mrstein/YANHAA/README.md

# YANHAA
YANHAA - You Are Not Heartless After All is an electronical stethoscope based on a MK20DX256 (TEENSY 3.2).
Still Work In Progress, the 3D files are not finished yet.
