mrstein/YANHAA/SW/PARABOLE.SLDPRT

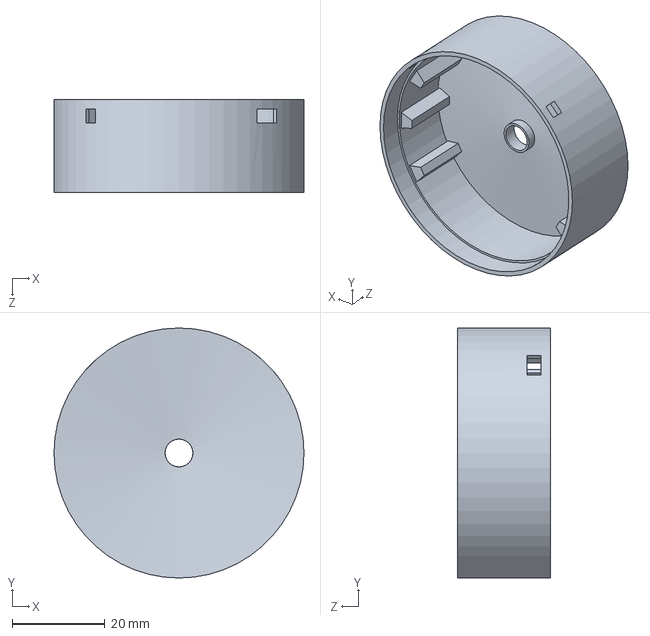
[picture p1: CAD file, 2017-12-03]
SW/PARABOLE.SLDPRT
54.0 x 54.0 x 20.0 mm
