mrstein/YANHAA/SW/Stethoscope v1.0.SLDPRT

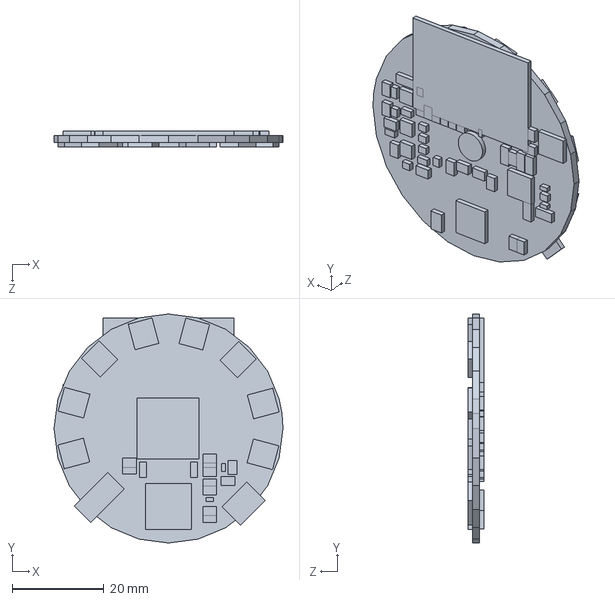
[picture p2: CAD file, 2017-12-03]
SW/Stethoscope v1.0.SLDPRT
50.0 x 50.0 x 3.60 mm
