mrstein/YANHAA/EAGLE/Stethoscope v1.0.brd

## EAGLE design EAGLE/Stethoscope v1.0.brd (2017-12-03)

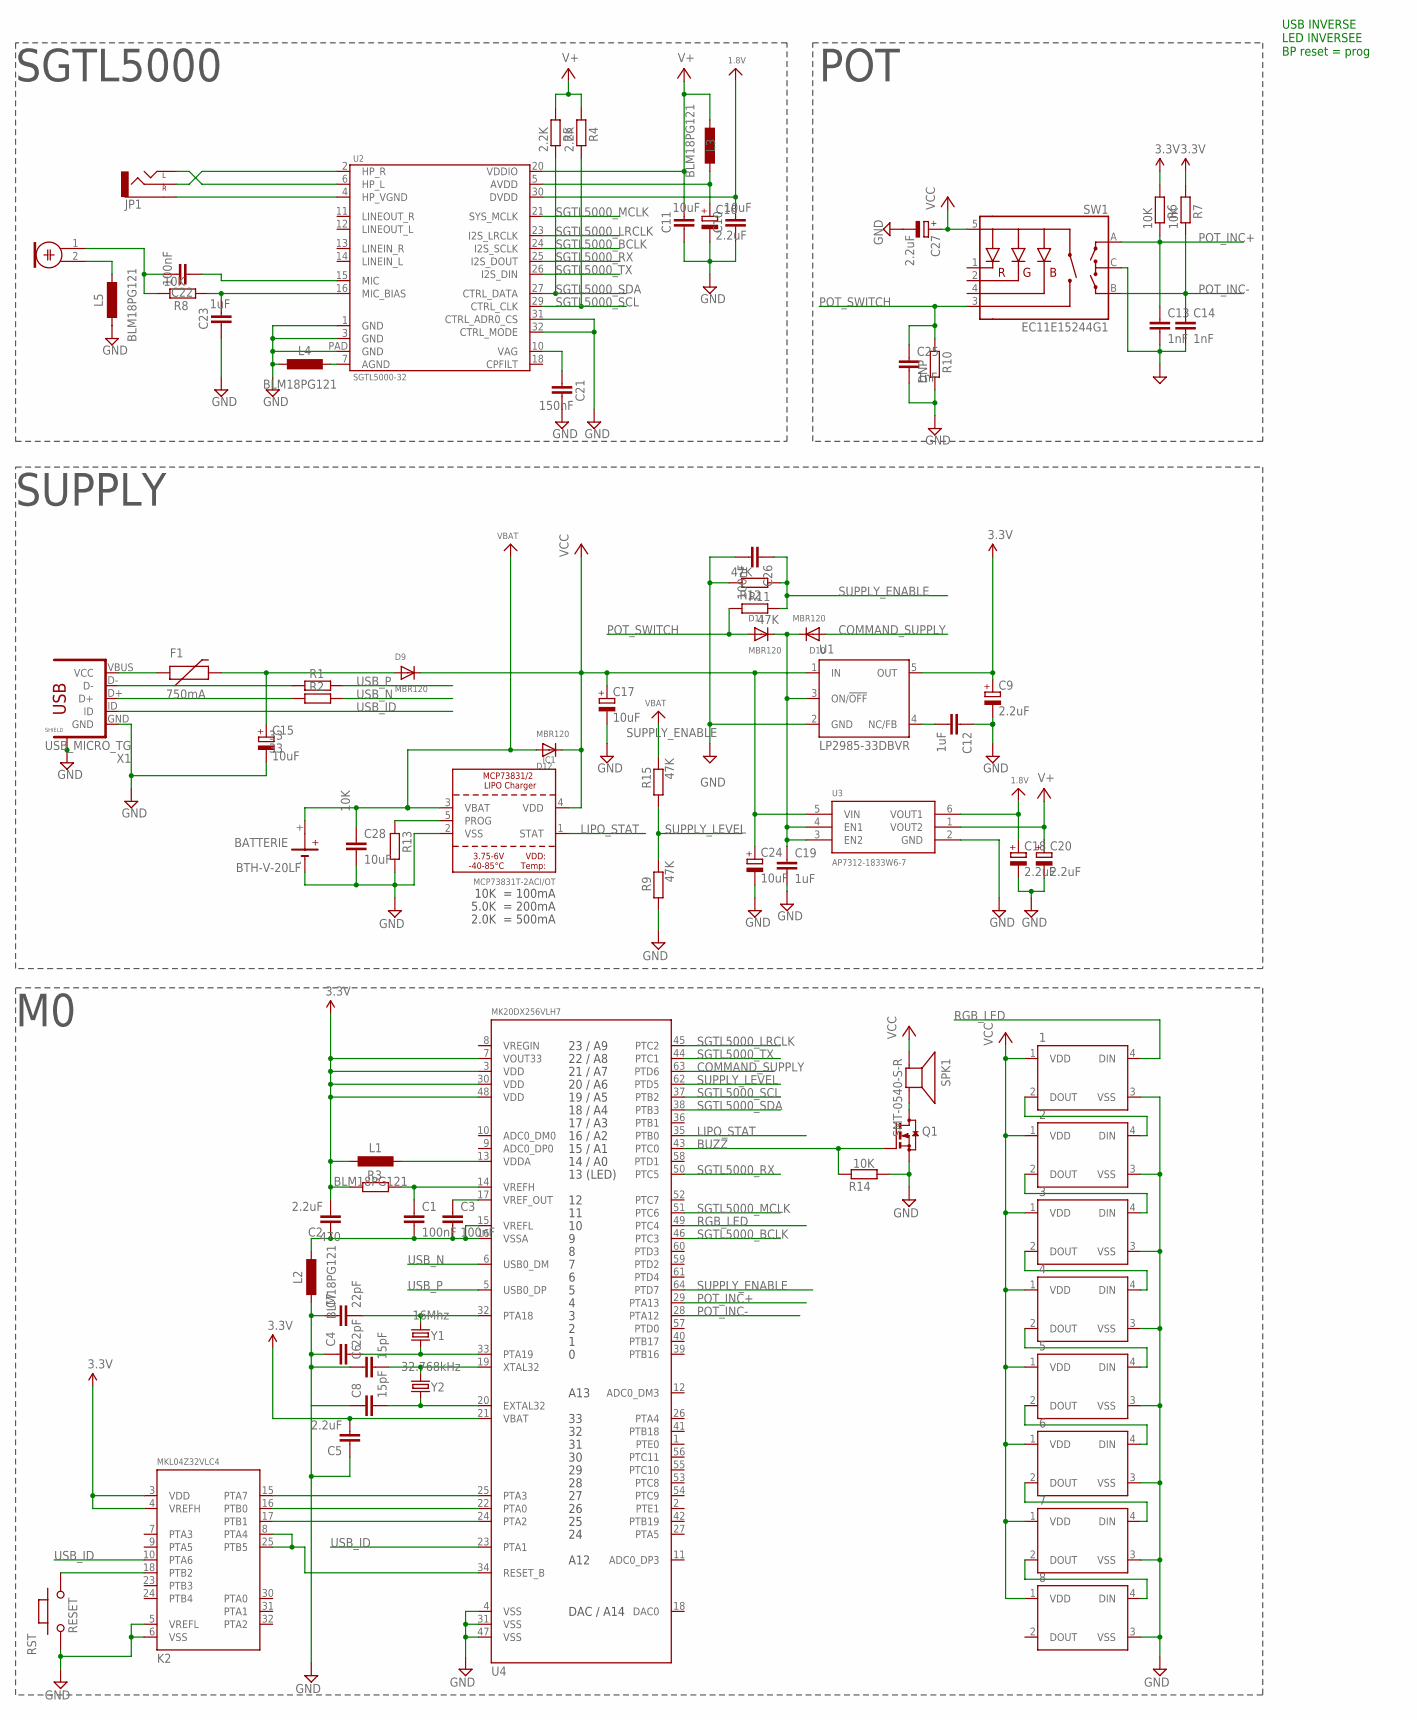
[picture p3: schematic Stethoscope v1.0.sch]

Parts:
1, 2, 3, 4, 5, 6, 7, 8: WS2812B
BATTERIE: BTH-V-20LF; 3V_BAT_HOLDER
C1, C3, C26: 100nF; C0603
C2, C5: 2.2uF; C0603
C4, C7: 22pF; C0603
C6, C8: 15pF; C0603
C9, C16, C18, C20, C27: 2.2uF; C0805POL
C10, C11: 10uF; C0805
C12, C19: 1uF; C0603
C13, C14, C25: 1nF; C0603
C15, C17, C24: 10uF; C0805POL
C21: 150nF; C0805
C22: 100nF; C0805
C23: 1uF; C0805
C28: 10uF; C1206
D9, D10, D11, D12: MBR120; SOD-323F
F1: 750mA; 0603
IC1: MCP73831T-2ACI/OT; SOT23-5
JP1: AUDIO-JACK1:1; STEREOJACK2.5MM
K2: MKL04Z32VLC4; LQFP32-08
L1, L2, L3, L4, L5: BLM18PG121; L0603
M1: ELECTRET_MICROPHON-F6050AP; F6050AP
Q1: BSS123; SOT23
R1, R2: 33; R0603
R3: 470; R0603
R4, R5: 2.2K; R0603
R6, R7, R8, R13, R14: 10K; R0603
R9, R11, R12, R15: 47K; R0603
R10: DNP; R0603
RST: RESET; 157SW
SPK1: SMT-0540-S-R
SW1: EC11E15244G1; ENCODER_LED_3_KIT
U1: LP2985-33DBVR; SOT23-DBV
U2: SGTL5000-32; QFN-32-5MM
U3: AP7312-1833W6-7; SOT23-6
U4: MK20DX256VLH7; LQFP64-05
X1: USB_MICRO_TG
Y1: 16Mhz; CRYSTAL-SMD-3.2X1.5MM
Y2: 32.768kHz; CRYSTAL-SMD-3.2X1.5MM

Connections:
1.8V: C10.2, C18.SMD+ (+), U2.30 (DVDD), U3.6 (VOUT1)
3.3V: C2.2, C5.2, C9.SMD+ (+), K2.3 (VDD), K2.4 (VREFH), L1.2, R3.2, R6.2, R7.2, U1.5 (OUT), U4.3 (VDD), U4.7 (VOUT33), U4.21 (VBAT), U4.30 (VDD), U4.48 (VDD)
BUZZ: Q1.1 (G), R14.2, U4.43 (PTC0)
COMMAND_SUPPLY: D10.A, U4.63 (PTD6)
COMMAND_SUPPLY2: C19.1, D10.C, D11.C, U1.3 (ON/!OFF), U3.3 (EN2), U3.4 (EN1)
GND: 1.3 (VSS), 2.3 (VSS), 3.3 (VSS), 4.3 (VSS), 5.3 (VSS), 6.3 (VSS), 7.3 (VSS), 8.3 (VSS), BATTERIE.-, C4.1, C5.1, C6.1, C7.1, C8.1, C9.SMD- (-), C10.1, C11.1, C12.1, C13.2, C14.2, C15.SMD- (-), C16.SMD- (-), C17.SMD- (-), C18.SMD- (-), C19.2, C20.SMD- (-), C21.2, C23.1, C24.SMD- (-), C25.2, C26.2, C27.SMD- (-), C28.2, IC1.2 (VSS), K2.5 (VREFL), K2.6 (VSS), L2.2, L4.2, L5.2, Q1.2 (S), R9.1, R10.1, R12.2, R13.1, R14.1, RST.1, SW1.C, U1.2 (GND), U2.1 (GND), U2.3 (GND), U2.31 (CTRL_ADR0_CS), U2.32 (CTRL_MODE), U2.PAD (GND), U3.2 (GND), U4.4 (VSS), U4.31 (VSS), U4.47 (VSS), X1.GND, X1.SHIELD, X1.SHIELD2 (SHIELD1), X1.SHIELD3 (SHIELD2), X1.SHIELD4 (SHIELD3), X1.SHIELD5 (SHIELD4), X1.SHIELD6 (SHIELD5), X1.SHIELD7 (SHIELD6), X1.SHIELD8 (SHIELD7)
LIPO_STAT: IC1.1 (STAT), U4.35 (PTB0)
unnamed: C16.SMD+ (+), L3.1, U2.5 (AVDD)
unnamed: L1.1, U4.13 (VDDA)
unnamed: K2.8 (PTA4), K2.25 (PTB5), U4.34 (RESET_B)
unnamed: C21.1, U2.10 (VAG)
unnamed: C6.2, U4.19 (XTAL32), Y2.P$2 (2)
unnamed: C15.SMD+ (+), D9.A, F1.2
unnamed: C23.2, R8.2, U2.16 (MIC_BIAS)
unnamed: C22.1, U2.15 (MIC)
unnamed: JP1.5 (SLEEVE), U2.4 (HP_VGND)
unnamed: JP1.1 (LEFT), U2.6 (HP_L)
unnamed: JP1.4 (RIGHT), U2.2 (HP_R)
unnamed: C8.2, U4.20 (EXTAL32), Y2.P$1 (1)
unnamed: C22.2, M1.1, R8.1
unnamed: R1.2, X1.D-
unnamed: R2.2, X1.D+
unnamed: L5.1, M1.2
unnamed: IC1.5 (PROG), R13.2
unnamed: L4.1, U2.7 (AGND)
unnamed: C12.2, U1.4 (NC/FB)
unnamed: C7.2, U4.32 (PTA18), Y1.P$2 (2)
unnamed: C4.2, U4.33 (PTA19), Y1.P$1 (1)
unnamed: F1.1, X1.VBUS (VCC)
unnamed: C1.1, R3.1, U4.14 (VREFH)
unnamed: C1.2, C2.1, C3.2, L2.1, U4.15 (VREFL), U4.16 (VSSA)
unnamed: C3.1, U4.17 (VREF_OUT)
unnamed: K2.15 (PTA7), U4.25 (PTA3)
unnamed: K2.16 (PTB0), U4.22 (PTA0)
unnamed: K2.17 (PTB1), U4.24 (PTA2)
unnamed: K2.18 (PTB2), RST.2
unnamed: 2.2 (DOUT), 3.4 (DIN)
unnamed: 3.2 (DOUT), 4.4 (DIN)
unnamed: 4.2 (DOUT), 5.4 (DIN)
unnamed: 5.2 (DOUT), 6.4 (DIN)
unnamed: 6.2 (DOUT), 7.4 (DIN)
unnamed: Q1.3 (D), SPK1.+ (-)
unnamed: 7.2 (DOUT), 8.4 (DIN)
unnamed: 1.2 (DOUT), 2.4 (DIN)
POT_INC+: C13.1, R6.1, SW1.A, U4.29 (PTA13)
POT_INC-: C14.1, R7.1, SW1.B, U4.28 (PTA12)
POT_SWITCH: C25.1, D11.A, R10.2, R11.1, SW1.3 (SW)
RGB_LED: 1.4 (DIN), U4.49 (PTC4)
SGTL5000_BCLK: U2.24 (I2S_SCLK), U4.46 (PTC3)
SGTL5000_LRCLK: U2.23 (I2S_LRCLK), U4.45 (PTC2)
SGTL5000_MCLK: U2.21 (SYS_MCLK), U4.51 (PTC6)
SGTL5000_RX: U2.25 (I2S_DOUT), U4.50 (PTC5)
SGTL5000_SCL: R4.1, U2.29 (CTRL_CLK), U4.37 (PTB2)
SGTL5000_SDA: R5.1, U2.27 (CTRL_DATA), U4.38 (PTB3)
SGTL5000_TX: U2.26 (I2S_DIN), U4.44 (PTC1)
SUPPLY_ENABLE: C26.1, R11.2, R12.1, U4.64 (PTD7)
SUPPLY_LEVEL: R9.2, R15.1, U4.62 (PTD5)
USB_ID: K2.10 (PTA6), U4.23 (PTA1), X1.ID
USB_N: R2.1, U4.6 (USB0_DM)
USB_P: R1.1, U4.5 (USB0_DP)
V+: C11.2, C20.SMD+ (+), L3.2, R4.2, R5.2, U2.20 (VDDIO), U3.1 (VOUT2)
VBAT: BATTERIE.+, C28.1, D12.A, IC1.3 (VBAT), R15.2
VCC: 1.1 (VDD), 2.1 (VDD), 3.1 (VDD), 4.1 (VDD), 5.1 (VDD), 6.1 (VDD), 7.1 (VDD), 8.1 (VDD), C17.SMD+ (+), C24.SMD+ (+), C27.SMD+ (+), D9.C, D12.C, IC1.4 (VDD), SPK1.- (+), SW1.5 (+), U1.1 (IN), U3.5 (VIN)

Notes on the sheet:
10K = 100mA
5.0K = 200mA
2.0K = 500mA
SGTL5000
SUPPLY
POT
23 / A9
22 / A8
21 / A7
20 / A6
19 / A5
18 / A4
17 / A3
16 / A2
15 / A1
14 / A0
13 (LED)
A13
A12
DAC / A14
USB INVERSE LED INVERSEE BP reset = prog

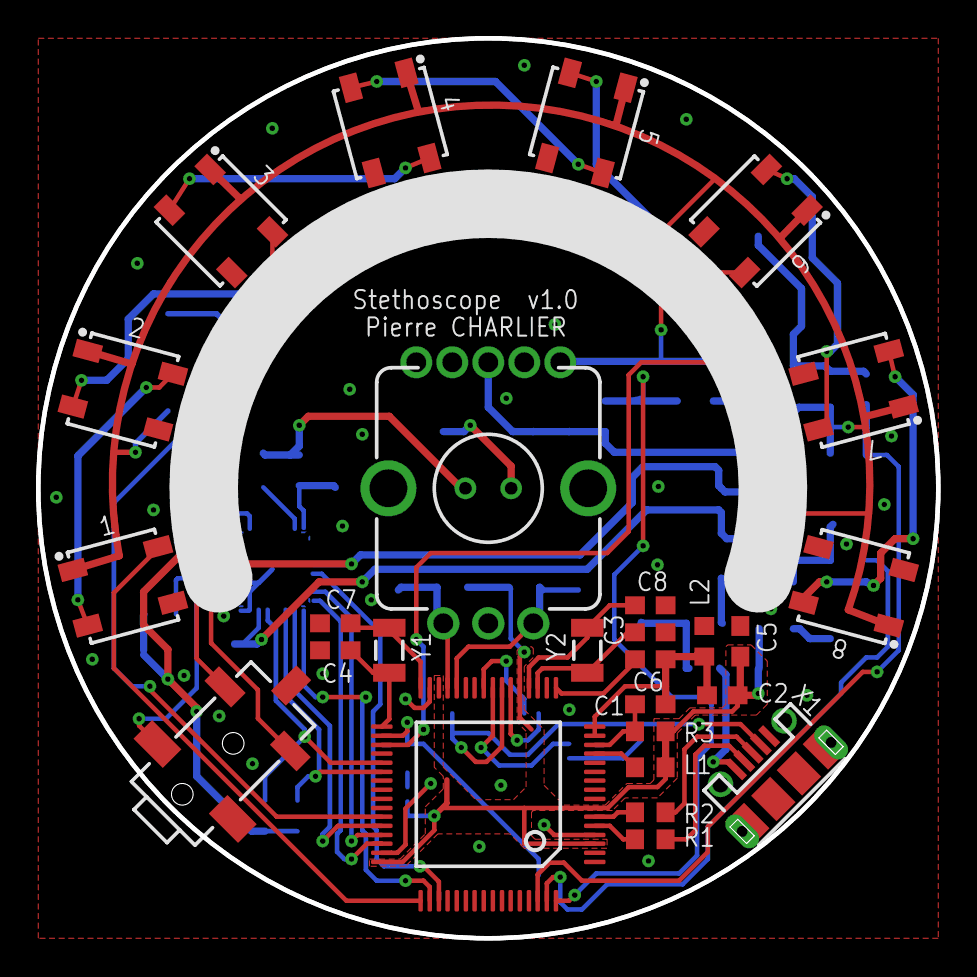
[picture p4: board Stethoscope v1.0.brd from above]

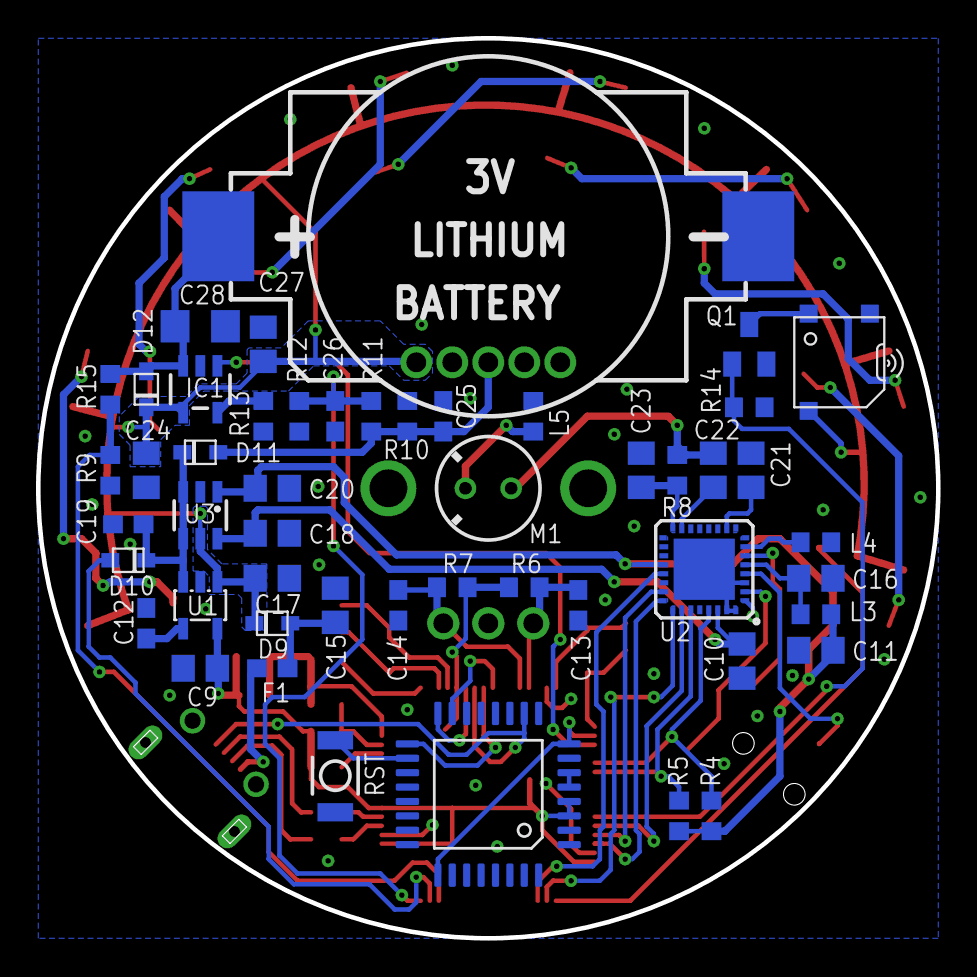
[picture p5: board Stethoscope v1.0.brd from below]

Board: 2 copper layers, 50.0 x 50.0 mm, 77 parts (50 on the bottom side), 63 nets.
